snakescb/xwLedControl/Software/xwLedConfigurator/Images/jet.jpg

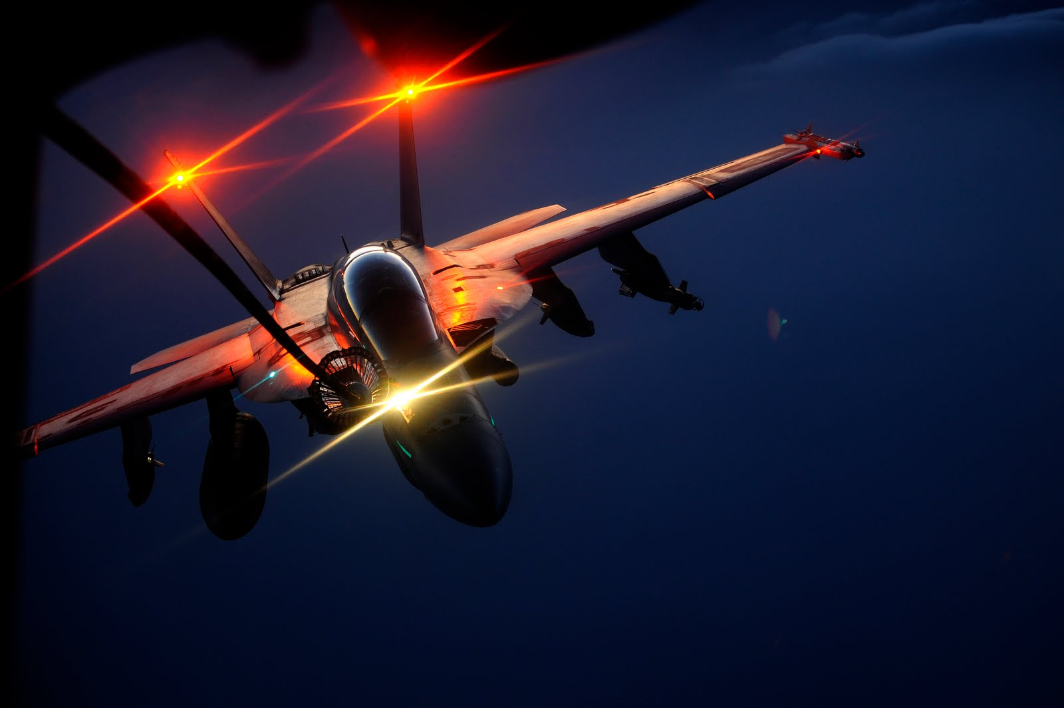
Software/xwLedConfigurator/Images/jet.jpg
