snakescb/xwLedControl/Firmware/docs/DefinitionFlashKonfig_V2.pdf

# Definition Konfigurationsinhalt xwLedControl

Firmware: xwLedControl ab V1.3
Konfig Version 1

Achtung: 16 und 32-Bit Werte müssen im Big-Endian Format gespeichert werden. Daher das Byte mit der höchsten Adresse enthält das MSB des Werts. (zB. Der Wert 0xABCD wird Byteweise gespeichert als 0xCD 0xAB)

Die Grösse des Konfigurationsbereich ist nicht fixiert und kann von Gerät zu Gerät variieren, sie kann allerdings mit einem XW-Com Befehl abgefragt werden. Konsequenterweise gibt es keine fixen Pointer, sondern nur Offsets von der Basisadresse. Offsets sind immer gegenüber der Basisadresse zu verstehen.

### Grundkonfiguration

Basisadresse: BaseAdress (Geräteabhängig)

Offset | Byte 0 | Byte 1 | Byte 2 | Byte 3
0x00 | Länge L der Konfiguration in Bytes
0x04 | Anzahl LED Sequenzen | | Konfig Typ | Konfig Version
0x08 | Offset zu Sequenz Header 0
0x0C | Offset zu Sequenz Header 1
0x10 | Offset zu Sequenz Header 2
0x14 | Offset zu Sequenz Header ...

### Sequenz Heade

Die Kanalfarben und Kanaloptionen werden in der Firmware nicht verwendet, sind aber dafür da, dass die PC Software beim Datenupload die original Softwarekanäle wieder herstellen kann.

Offset | Byte 0 | Byte 1 | Byte 2 | Byte 3
0x00 | Sequenznamen (12 byte)
0x04
0x08
0x0C | Anzahl Ausgänge in Sequenz (n) | Sequenz Dimmwert | Unused
0x10 | Sequenz Geschwindigkeit
0x14 | Offset auf Kanalheader 0
0x18 | Offset auf Kanalheader 1
0x1C | Offset auf Kanalheader 2
0x20 | Offset auf Kanalheader ...
… | …

### Kanalheader

Pro Sequenz und Ausgang ist eine Tabelle mit Kanalinformation und einem Offset auf die LED Objekte.

Die Kanalfarben und Kanaloptionen werden in der Firmware nicht verwendet, sind aber dafür da, dass die PC Software beim Datenupload die original Softwarekanäle wieder herstellen kann

Offset | Byte 0 | Byte 1 | Byte 2 | Byte 3
0x00 | Kanal Ausgang | Kanal Dimmwert | Kanal Min Aux | Kanal Max Aux
0x04 | Kanalfarbe Rot | Kanalfarbe Grün | Kanalfarbe Blau | Kanal Farbtyp
0x08 | Offset auf erstes LED Objekt

Kanal LED Objekte

Fortlaufende Tabelle mit LED Objekten, immer 12 bytes pro Objekt. Das letzte Objekt in einer Tabelle ist immer ein EOD

0x00 | Definition Objekt 0
0x0C | Definition Objekt 1
…
… | Letztes Objekt, EOD

### LED Objekte

Objekt ID | Objekt Name | Anzahl Bytes
0x01 | SOB: Set Output Brightness | 12
0x02 | LOB: Linear Output Brightness | 12
0x03 | BLK: Blink Output | 12
0x04 | DIM: Dimming Output | 12
0xF0 | EOD: End Of Definition | 12

### SOB: Set Output Brightness

Setzt einen PWM Ausgang auf einen fixen Wert. Ist die Laufzeit abgelaufen, wird das nächste Objekt ausgeführt.

Offset | Byte 0 | Byte 1 | Byte 2 | Byte 3
0x00 | SOB | Brightness (0-255) | Laufzeit in Millisekunden
0x04 | Unused
0x08 | Unused

### LOB: Linear Output Brightness

Setzt einen PWM Ausgang auf den Startwert. Der Ausgang wird dann Linear über die dynamische Laufzeit auf den Endwert gedimmt.

Offset | Byte 0 | Byte 1 | Byte 2 | Byte 3
0x00 | LOB | Brightness Start (0-255) | Brightness End (0-255) | Unused
0x04 | Laufzeit in Millisekunden | | Unused
0x08 | Unused

### BLK: Blink Output

Das Objekt läuft für „Lebensdauer“. Während dieser Zeit ist der Ausgang für „DutyCycle*Periodendauer“ eingeschaltet (Brightness On) und dann für „(1-DutyCycle)*Periodendauer“ ausgeschaltet (Brightness Off). DutyCycle muss zwischen 0 und 100 sein.

Offset | Byte 0 | Byte 1 | Byte 2 | Byte 3
0x00 | BLK | Brightness On (0-255) | Brightness Off (0-255) | Duty Cycle
0x04 | Objekt Lebesdauer | | Periodendauer
0x08 | Unused

### DIM: Dimming Output

Setzt einen PWM Ausgang während der Einschaltzeit in den Dimming Modus. In diesem Modus kann die Helligkeit stufenlos per Empfänger zwischen „MinVal“ und „MaxVal“ eingestellt werden. Ist die Einschaltzeit = 0 läuft das Objekt endlos bis die Sequenz umgeschaltet wird.

Offset | Byte 0 | Byte 1 | Byte 2 | Byte 3
0x00 | DIM | MinVal (0-255) | MaxVal (0-255) | Unused
0x04 | Einschaltzeit in Millisekunden | | Unused
0x08 | Unused

### EOD: End Of Definition

Definiert das Ende einer Definitionstabelle. In jeder Tabelle zwingend notwendig. Der Parameter Continuation definiert, in welchem Modus der Ausgang weiter behandelt werden soll.

Offset | Byte 0 | Byte 1 | Byte 2 | Byte 3
0x00 | EOD | Continuation: 0: Der Ausgang wird nicht weiter angesteuert und bleibt so lange konstant, bis eine neue Sequenz gestartet wird. 1: Der gesamte Ablauf beginnt sofort erneut von vorne. 2: Der gesamte Ablauf beginnt sofort in umgekehrter Reihenfolge und umgekehrter Zeitachse. Nachdem das erste Objekt erreicht und abgearbeitet ist, beginnt der Ablauf wieder vorwärts. | Unused
0x04 | Unused
0x08 | Unused
