snakescb/xwLedControl/Hardware/V2.0/BOM_PCB_xwLightControl-V2.0.csv

ID | Name | Designator | Footprint | Quantity | Manufacturer Part | Manufacturer | Supplier | Supplier Part | Price
1 | WSD3020DN | Q2,Q4,Q3 | DFN-8_L3.2-W3.2-P0.65-LS3.4-BL-EP | 3 | WSD3020DN | Winsok Semicon | LCSC | C377873 | 0.277
2 | 47kΩ | R4,R5,R8,R9,R10,R13 | R0402 | 6 | 0402WGF4702TCE | UniOhm | LCSC | C25792 | 0.001
3 | 100nF | C5,C15,C16,C17,C18,C19,C13,C14 | C0402 | 8 | CL05B104KB54PNC | Samsung Electro-Mechanics | LCSC | C307331 | 0.006
4 | 1uF | C7,C28,C2 | C0402 | 3 | CL05A105KA5NQNC | SAMSUNG | LCSC | C52923 | 0.003
5 | 2.2kΩ | R6,R15,R16,R17 | R0402 | 4 | 0402WGF2201TCE | UniOhm | LCSC | C25879 | 0.001
6 | PESD5V0S1BA-N | D16,D17,D18 | SOD-323_L1.8-W1.3-LS2.5-BI | 3 | PESD5V0S1BA-N | Bourne Semicon (Shenzhen) | LCSC | C314260 | 0.058
7 | micro USBFemale | USB1 | MICRO-USB-SMD_5P-P0.65-H-F_C10418 | 1 | micro USBFemale | ValuePro | LCSC | C10418 | 0.071
8 | 4.7uF | C9,C10 | C0402 | 2 | CL05A475MP5NRNC | SAMSUNG | LCSC | C23733 | 0.006
9 | 1kΩ | R3,R2 | R0402 | 2 | 0402WGF1001TCE | UniOhm | LCSC | C11702 | 0.001
10 | 10kΩ | R7,R12 | R0402 | 2 | 0402WGF1002TCE | UniOhm | LCSC | C25744 | 0.001
11 | STM32F103T8U6 | U1 | VFQFPN36_L6.0-W6.0-P0.50-BL-EP3.7 | 1 | STM32F103T8U6 | ST | LCSC | C19671 | 6.077
12 | CP2102N-A02-GQFN20R | U3 | QFN-20_L3.0-W3.0-P0.50-BL-EP1.7_EFM8BB21F16G | 1 | CP2102N-A02-GQFN20R | SILICON LABS(芯科) | LCSC | C969913 | 3.938
13 | 18pF | C6,C12 | C0402 | 2 | 0402CG180J500NT | FH | LCSC | C1549 | 0.001
14 | 8MHz | X1 | OSC-SMD_4P-L3.2-W2.5-BL | 1 | DSX321G 8MHz | KDS | LCSC | C57131 | 0.677
15 | SMF05CT1G | D2 | SOT-363_L2.0-W1.3-P0.65-LS2.1-TL | 1 | SMF05CT1G | ON | LCSC | C15879 | 0.27
16 | FC-F1005WD-455K5 | LED1 | LED0402-RD | 1 | FC-F1005WD-455K5 | NATIONSTAR | LCSC | C130725 | 0.042
17 | 47Ω | R11 | R0402 | 1 | 0402WGF470JTCE | UniOhm | LCSC | C25118 | 0.001
18 | LM4040CIM3-2.5/NOPB | U5 | SOT-23-3_L2.9-W1.3-P1.90-LS2.4-BR | 1 | LM4040CIM3-2.5/NOPB | TI | LCSC | C134019 | 0.643
19 | 22uF | C1,C3 | C1206 | 2 | CL31A226KAHNNNE | SAMSUNG | LCSC | C12891 | 0.073
20 | 22uF | C4 | C0603 | 1 | CL10A226MQ8NRNC | SAMSUNG | LCSC | C59461 | 0.009
21 | B5819W_C8598 | D3,D4,D5 | SOD-123_L2.7-W1.6-LS3.7-RD-1 | 3 | B5819W | CJ | LCSC | C8598 | 0.044
22 | HT7533-1_C14289 | U6 | SOT-89-3_L4.5-W2.5-P1.50-LS4.2-BR | 1 | HT7533-1 | HOLTEK | LCSC | C14289 | 0.227
23 | AO3400A | Q1 | SOT-23-3_L2.9-W1.6-P1.90-LS2.8-BR | 1 | AO3400A | AOS | LCSC | C20917 | 0.189
24 | 4.7kΩ | R1 | R0402 | 1 | 0402WGF4701TCE | UniOhm | LCSC | C25900 | 0.001
