snakescb/xwLedControl/Hardware/V2.0/Schematic_xwLightControl-V2.0.pdf

## Control

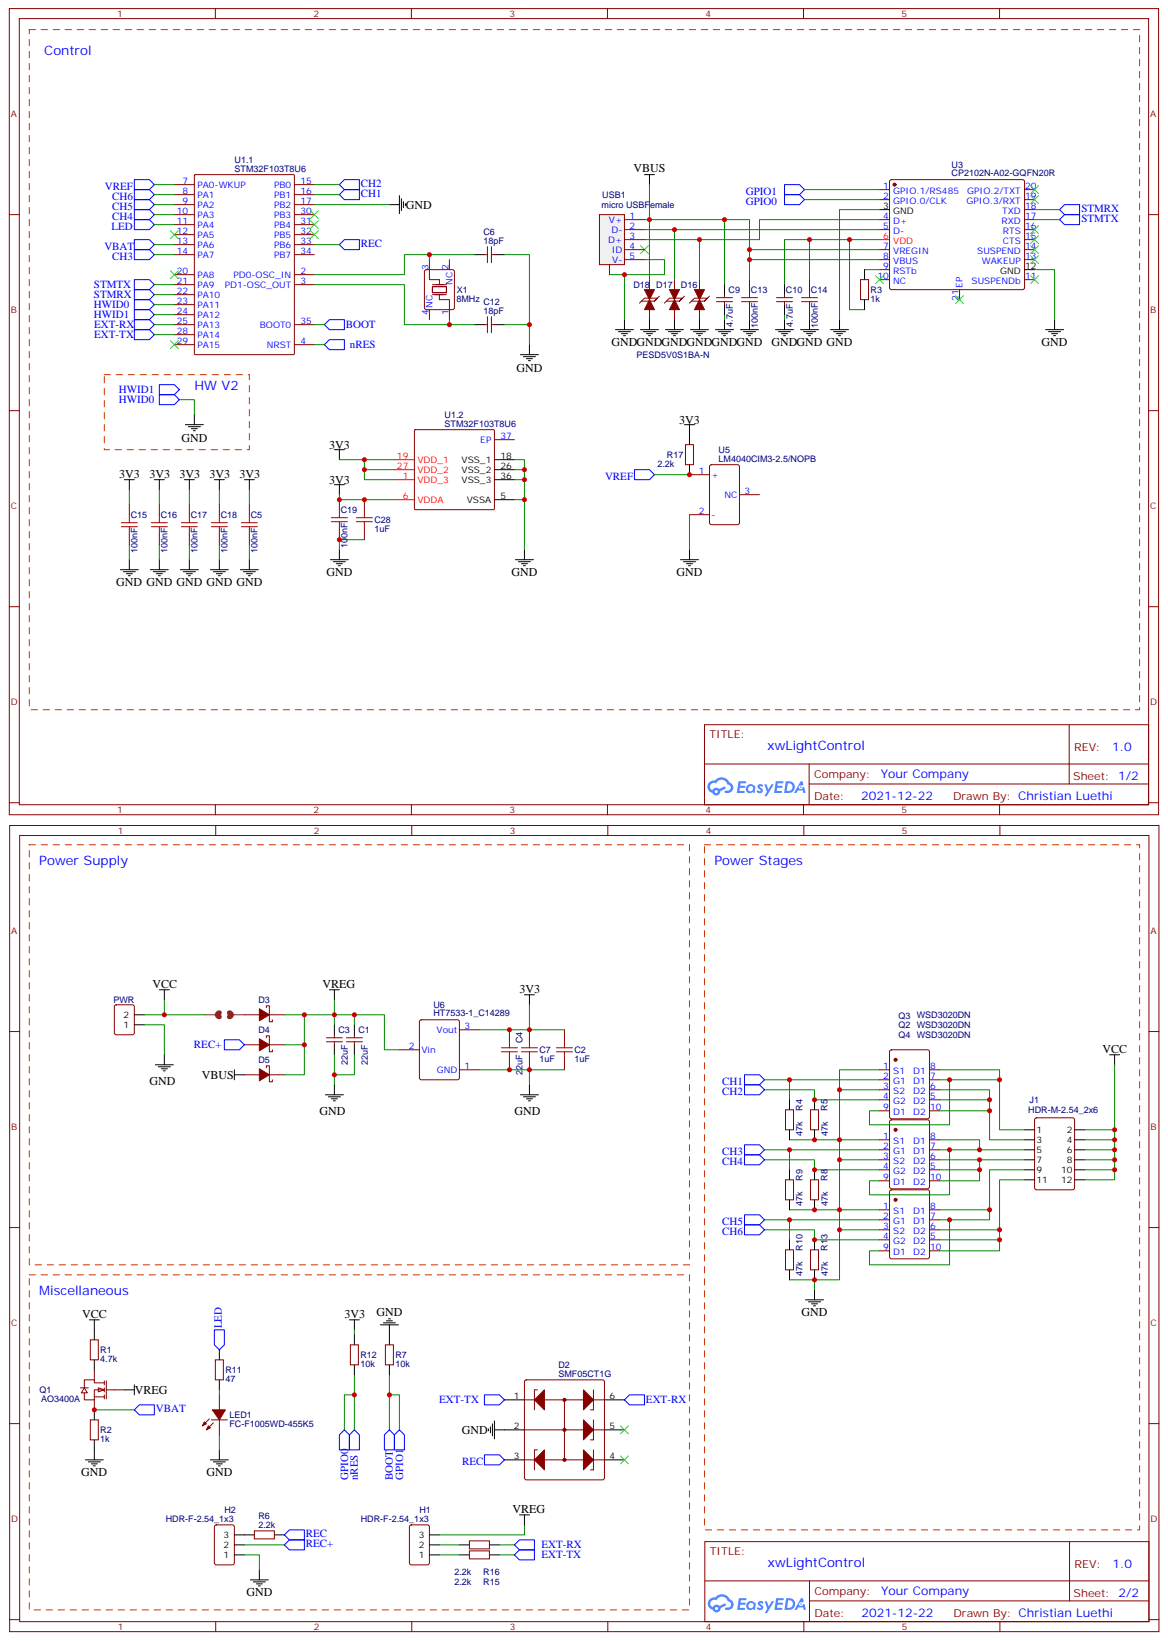
[picture p7: page 1]

Drawn By: Christian Luethi
