snakescb/xwLedControl/Hardware/V1.1/Schematic_xwLightControl-V1.1.pdf

## Control

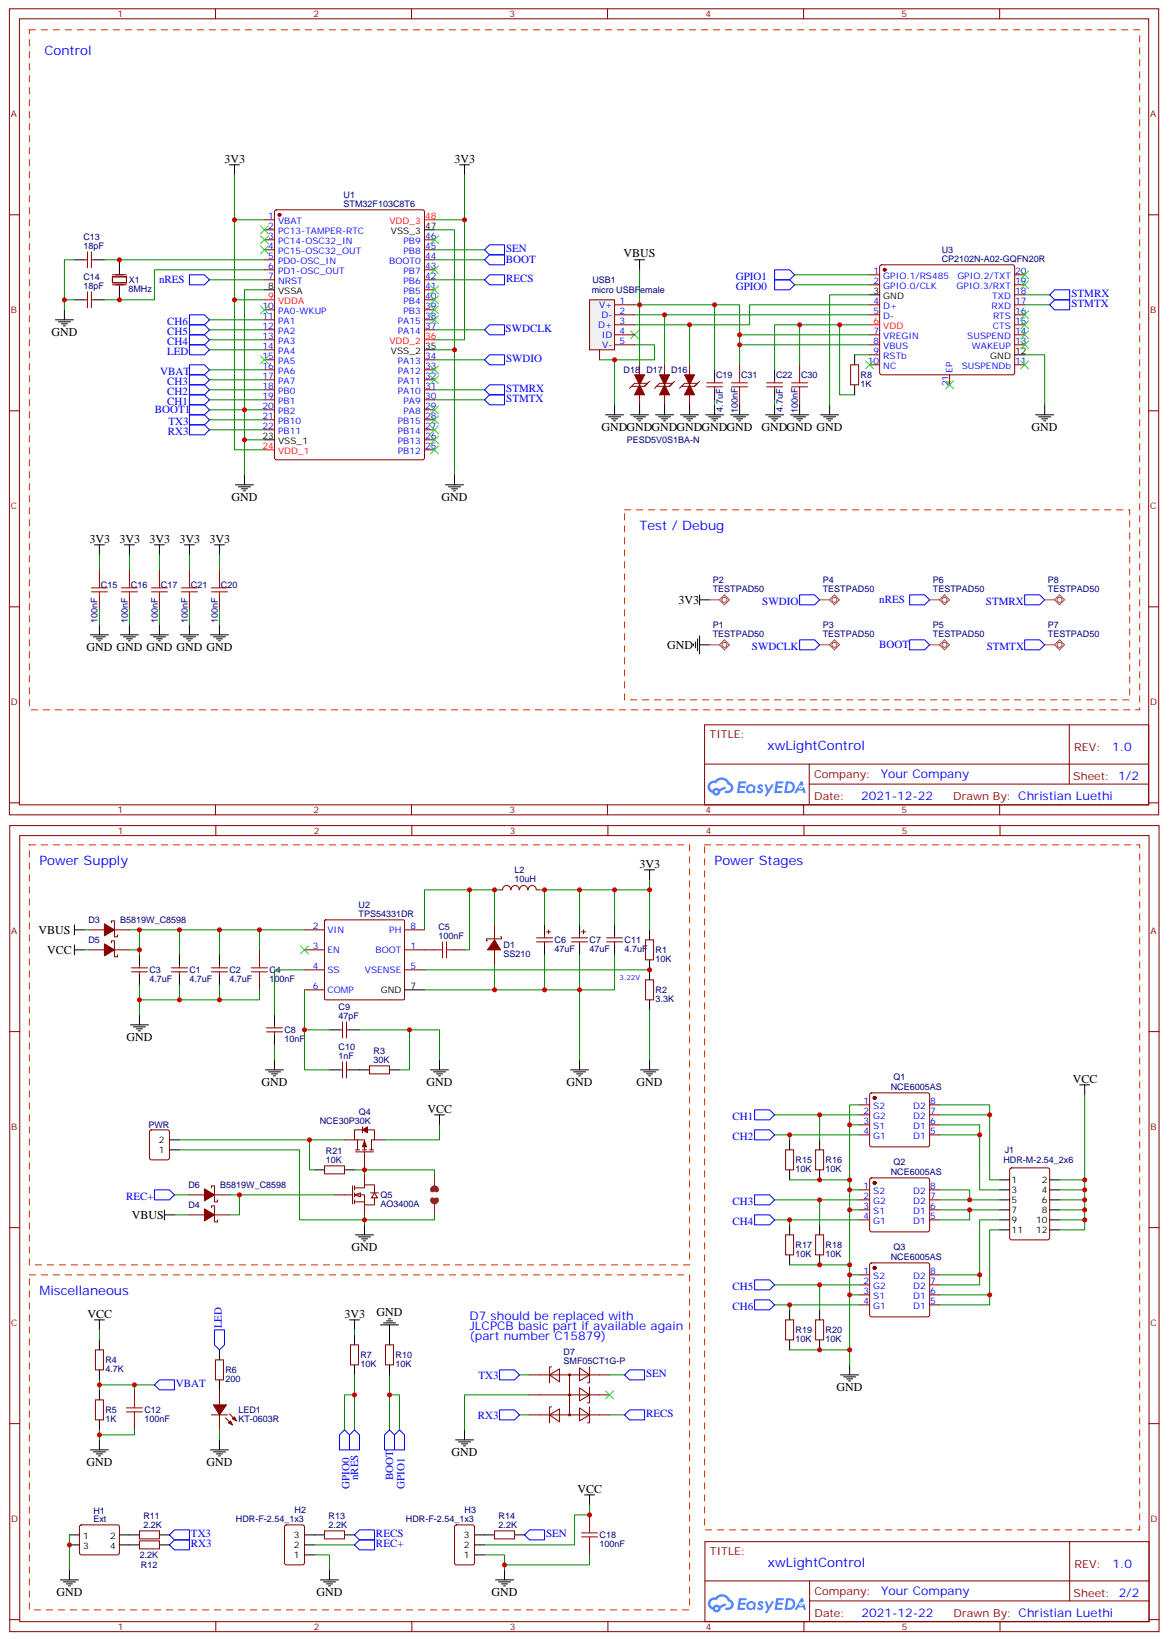
[picture p8: page 1]

Drawn By: Christian Luethi

D7 should be replaced with
JLCPCB basic part if available again
(part number C15879)
