snakescb/xwLedControl/Hardware/V1.0/Schematic_xwLightControl-V1.0.pdf

## Control

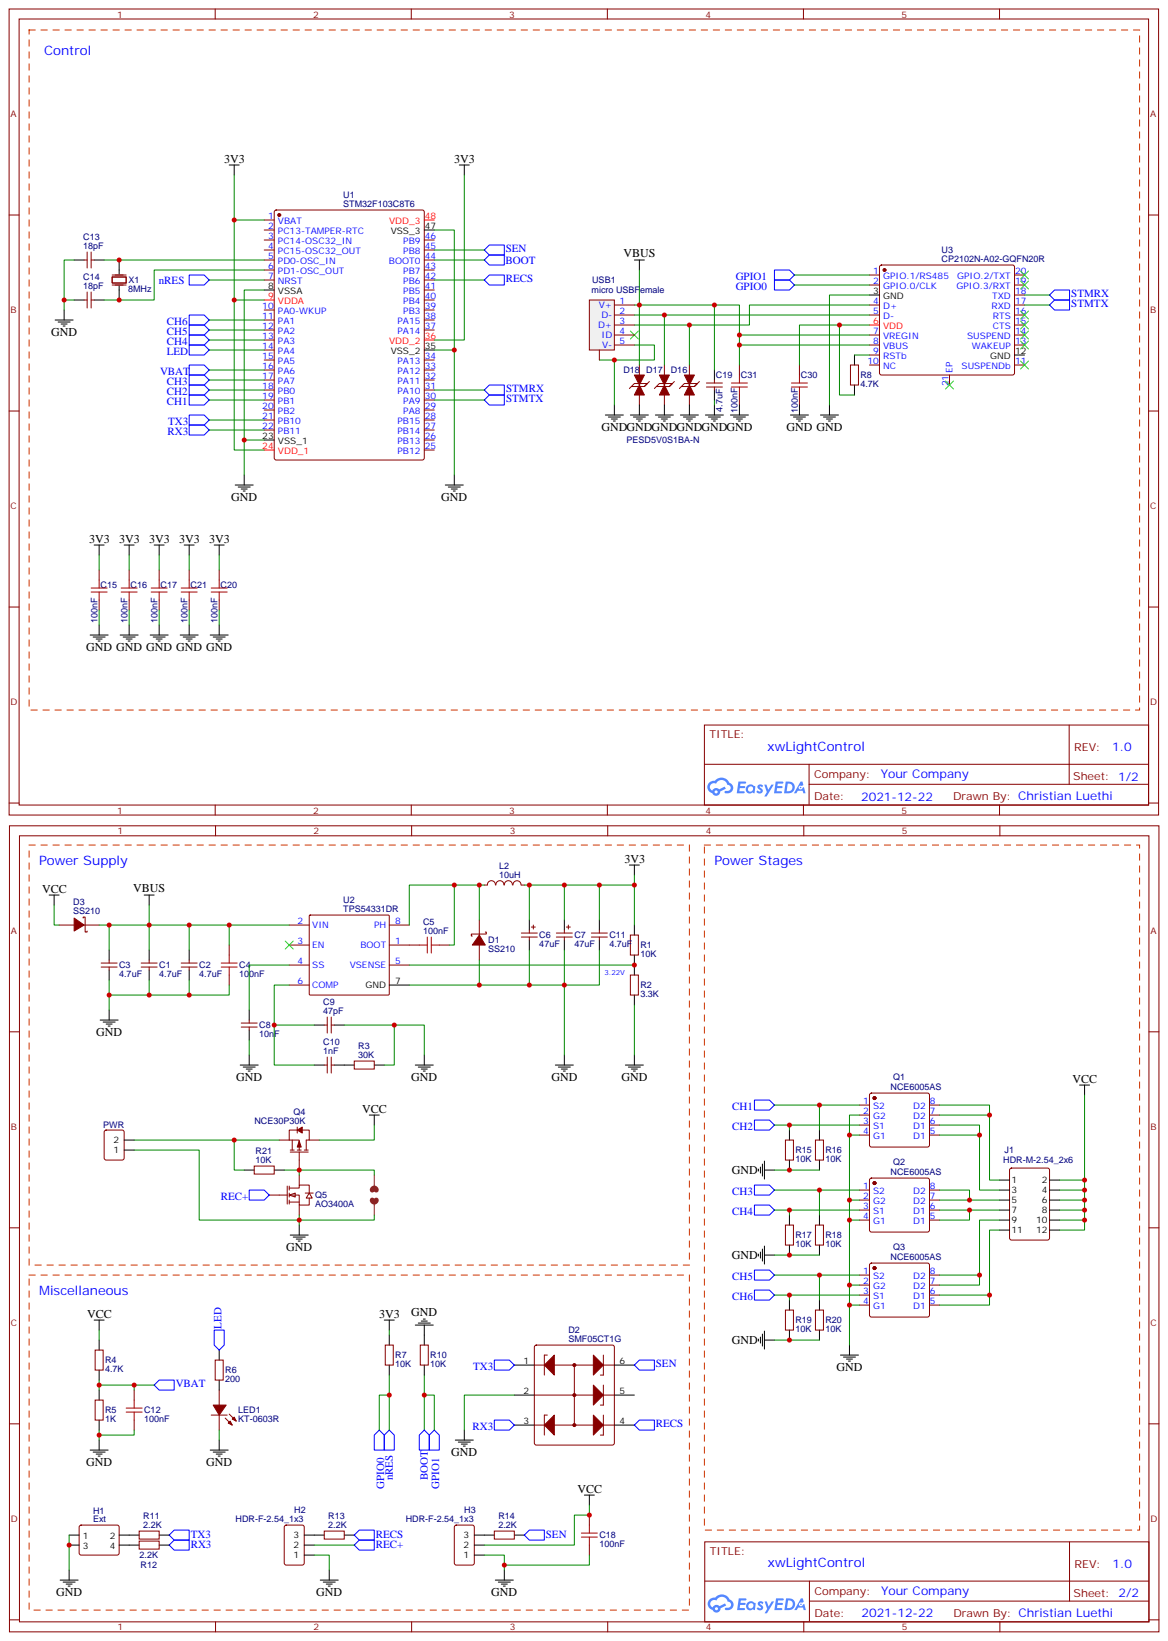
[picture p9: page 1]

Drawn By: Christian Luethi
