snakescb/xwLedControl/Hardware/V1.0/Schematic_xwLightControl_V1.0.pdf

## Control

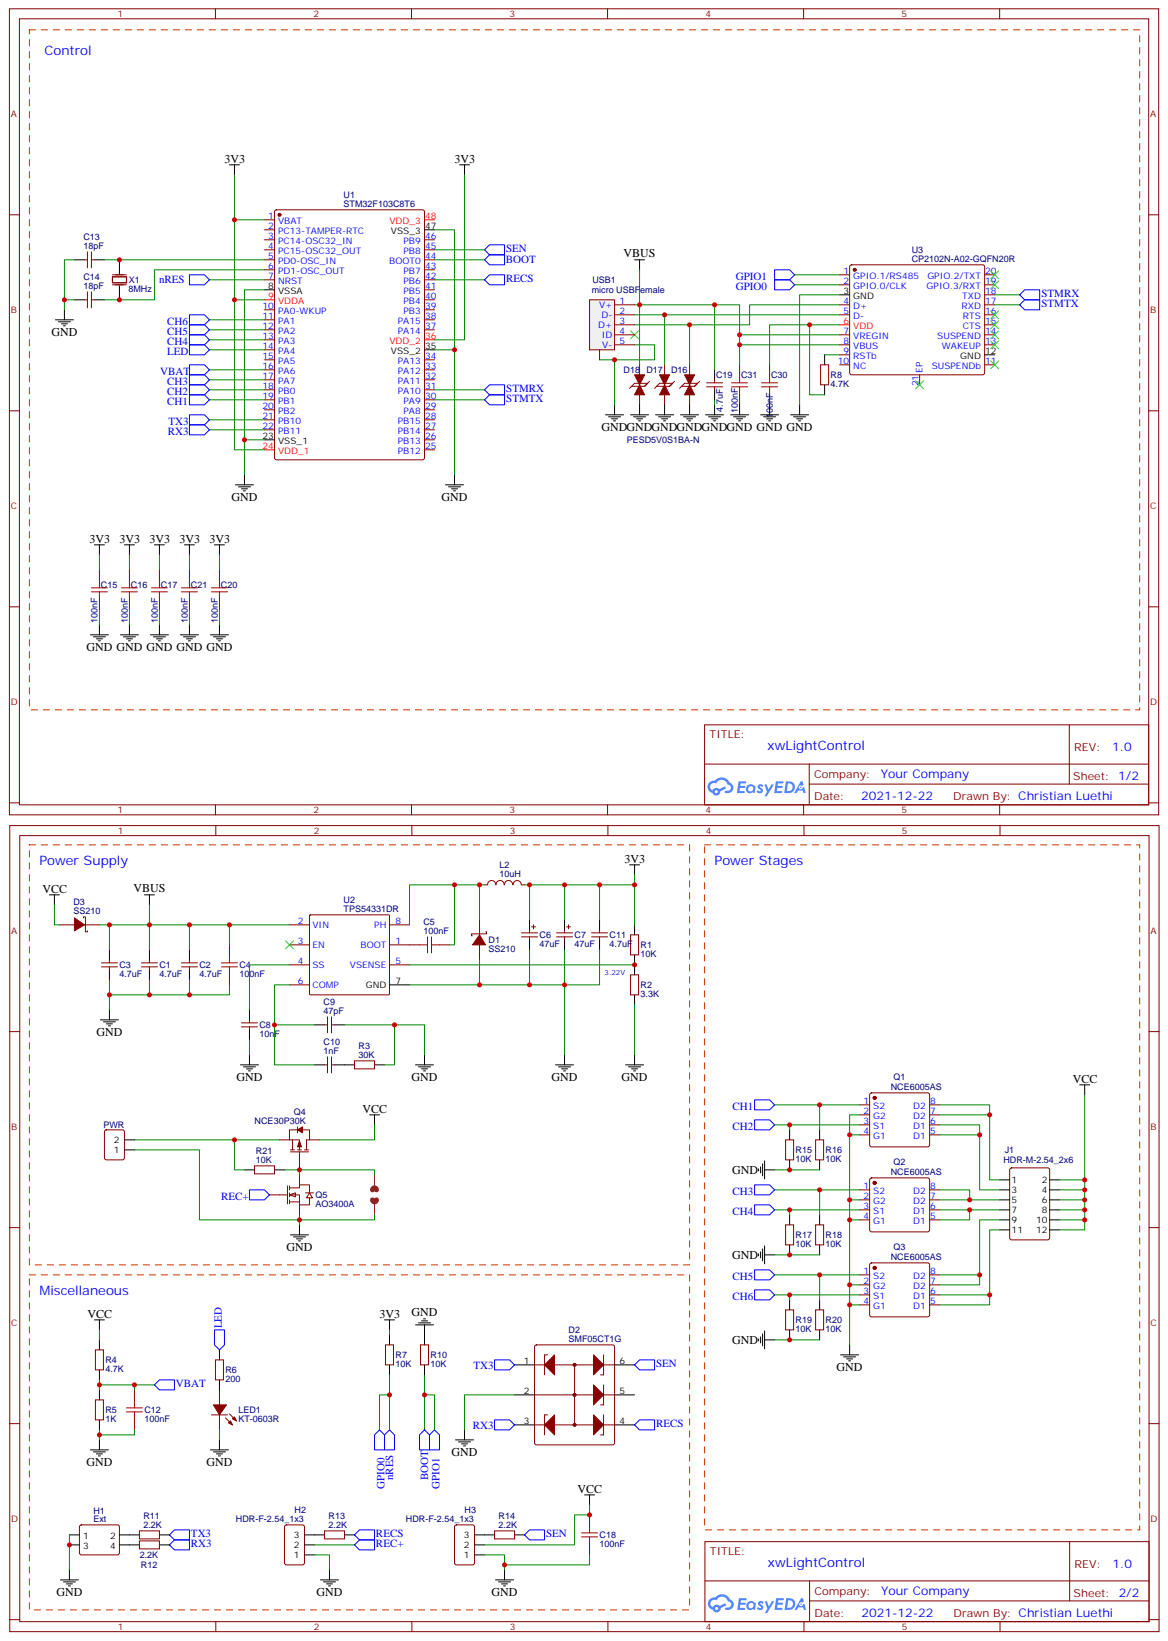
[picture p10: page 1]

Drawn By: Christian Luethi
