snakescb/xwLedControl/Firmware/src/masterSlave.h

/***************************************************************************//**
 * @file        masterSlave.h
 * @author      Created: CLU
 * @brief       Master / Slave Verbindung
 ******************************************************************************/
#ifndef MASTERSLAVE_H
#define MASTERSLAVE_H

/******************************************************************************
 Imported Include References
******************************************************************************/
#include "common.h"

/**************************************************************************//**
 * @brief    initialisierung
 *****************************************************************************/
void masterSlave_init(void);

/**************************************************************************//**
 * @brief    update, sollte im mainloop aufgerufen werden
 *****************************************************************************/
void mastertSlave_hisr(void);

/**************************************************************************//**
 * @brief    zum senden von neuen Daten
 *****************************************************************************/
void masterSlave_sendMasterData(uint8_t numBytes, uint8_t* data);

#endif //MASTERSLAVE_H
