snakescb/xwLedControl/(commit log)

2022-01-06 Production Files V1.0
    [BOM_PCB_xwLightControl_V1.0.csv, PickAndPlace_PCB_xwLightControl_V1.0.csv]
2022-02-26 V1.1 release
    Firmware: Implemented new configuration layout
    Software: Fixed sequence editing
    [common.h, ledControl.c]
